m-labs/board-m1/r4/Audio.sch

## KiCad design r4/Audio.sch (2012-06-22)

Schematic: Audio.sch

Parts:
C1, C3, C13, C30, C31, C32, C254: 100n; 0402
C2, C34, C253: 10u; 0805P
C4, C5, C7, C8, C9, C10, C11, C12, C14, C18, C20, C35, C36: 1u; 0402
C6: 2u2; 0805P
C19, C21, C22, C23, C25: 10u; 0805
C28, C29: 33p; 0402
C255: 47n; 0402
J1, J2: SCJ368R1NUS0B00G; phonejack-3.5-5
J3: 68002-103HLF; HDR-3x1-100mil
J23, J26: 68002-104HLF; HDR-4x1-100mil
L2: CB100505T-601Y; 0402
MK1: MP33125; MIC-RA-DIP-9.7mmx6.7mm
R10, R11, R12, R20, R21, R23, R24: 6k8; 0402
R13: 2k2; 0402
R17, R18, R26, R27: 10k; 0402
R25, R233: 100k; 0402
R28: 1M; 0402
R230, R231: 100R; 0402
TP5, TP6, TP7, TP8: TESTPOINT; PAD_C_1mm
U1: WM9707SCFT/V; QFP48
V24, V25, V26, V27, V28, V29, V30, V32, V33: AVR-M1005C080MTACB; 0402
Y1: 24.576MHz; xtal4-6mmx3.6mm

Notes on the sheet:
V29, V30, V32, V33 -> AVR-M1005C080MTACB Vdc 5.5V, 33 pF@1 KHz
V[24:28] -> AVR-M1005C080MTACB Vdc 5.5V, 33 pF@1 KHz
Normal = Low Plug-in = High
DNP inputs DC block capacitors: C4 -> AUXL, C5 -> AUXR, C7 -> VIDEOL, C8 -> VIDEOR, C14 -> MIC2 DNP output DC block capacitor: C22 -> MONOOUT
Notes: 1. Tolerance about resistors is 1% in default.
