m-labs/board-m1/r4/DVI-ISingle.sch

## KiCad design r4/DVI-ISingle.sch (2012-06-22)

Schematic: DVI-ISingle.sch

Parts:
C135: 4n7; 1206
C179: 10u; 0805P
C180, C181, C182: 10n; 0402
C183, C184, C185, C186, C189, C190: 100n; 0402
C187: 1u; 0402
C188, C288: 10u; 0805
D5: AD1580BRTZ; SOT23
J17: 74320-1004; DVI-RECEPT-RA
L13: CB100505T-601Y; 0402
Q1, Q2, Q4: 2N7002MTF; SOT23
R141: 1k; 0402
R142: 560R; 0402
R143, R232, R235: 10k; 0402
R144, R145, R146: 75R; 0402
R147, R148, R149, R150: 4k7; 0402
R156: 1M; 1206
TP10: TESTPOINT; PAD_C_1mm
U18: ADV7125KSTZ140; QFP48
U19, U20: SN74LVC1G17DBV; SOT-235
U32: MIC2090-1YM5; SOT-235
V12, V13, V14, V15, V16, V17, V18, V19, V31: EZJ-Z0V80010; 0402

Notes on the sheet:
EZJ-Z0V80010 : Vdc 10V, 0.8 pF@1 MHz
Place those EZJ-Z0V80010 varistors V[12..19] close to J17's related pins.
Notes: 1. Tolerance about resistors is 1% in default.
