m-labs/board-m1/r4/Dram.sch

## KiCad design r4/Dram.sch (2012-06-22)

Schematic: Dram.sch

Parts:
C156: 1u; 0402
C157, C162, C167, C168, C169, C170, C242, C243, C244, C245, C250, C251, C252: 100n; 0402
C158, C159, C160, C161, C163, C164, C165, C166: 10n; 0402
C240, C248: 100u; 1210P
R71, R72, R73, R74, R75, R76, R77, R78, R79, R80, R81, R82, R83, R84, R85, R86, R87, R88, R89, R90, R93, R94, R95, R96, R97, R98, R99, R100, R101, R102, R103, R104, R105, R106, R107, R108, R109, R110, R111, R112, R114, R115, R116, R117, R118, R119, R120, R121, R122, R123, R124, R125, R126, R127, R128, R129, R130, R131, R132, R133: 33R; 0402
R91: 120R; 0402
R92, R113, R134, R135: 1k; 0402
U14, U15: MT46V32M16P; TSOP-66

Notes on the sheet:
For U15
For U14
Notes: 1. Tolerance about resistors is 1% in default.
Bypass Cap.: Pin 1 3 9 15 18 ------------------------------ U14 C162 C243 C163+C244 C164 C245 U15 C159 C251 C158+C252 C157 C156 Pin 33 55 61 ------------------------------ U14 C165+C240 C242 C166 U15 C161+C248 C250 C160
