m-labs/board-m1/r4/EXPANSION_RESET.sch

## KiCad design r4/EXPANSION_RESET.sch (2012-06-22)

Schematic: EXPANSION_RESET.sch

Parts:
C273: 4n7; 1206
J21, J22: CONN_10X2; HE-10x2-100mil
J25: CONN_2; HE-1x2-100mil
J27: MH; SPACER-3mm-7mm-9.5mm
R30, R185: 10k; 0402
R39: 330R; 0402
R234: 1M; 1206
TP35, TP36: TESTPOINT; PAD_C_1mm
U22: XC6SLX45-2FGG484C; BGA-484
U24: APX803-40SAG-7; SOT23
U25: 74AUP1G08GW,125; TSSOP5

Notes on the sheet:
J27 : Mechanical mounting hole Place J27 close to J21:19 or 20 pin.
Note: Users can build their own extension board to connect these two J21 and J22 board-to-board female headers.
Default: M1r4 ships with the jumper plug included, one contact of the the jumper be placed on J25.1
J21, 22 Harwin p/n : M20-7831046 or FCI p/n : 87606-310LF
Notes: 1. Tolerance about resistors is 1% in default.
