m-labs/board-m1/r4/Ethernet.sch

## KiCad design r4/Ethernet.sch (2012-06-22)

Schematic: Ethernet.sch

Parts:
C37, C40, C42: 1u; 0402
C38, C39, C41, C43, C44, C45, C47, C48: 100n; 0402
C46: 4n7; 1206
J4: 48025-0002; RJ45-8-LED
L4, L5, L6: CB100505T-601Y; 0402
R29: 4k7; 0402
R31: 6k65; 0402
R32, R33, R34, R35: 49R9; 0402
R36, R38: 220R; 0402
R37: 1M; 1206
R174: 1k; 0402
TP9: TESTPOINT; PAD_C_1mm
U2: KSZ8001L; QFP48

Notes on the sheet:
Notes: 1. Tolerance about resistors is 1% in default.
