m-labs/board-m1/r4/FPGA_BANK2.sch

## KiCad design r4/FPGA_BANK2.sch (2012-06-22)

Schematic: FPGA_BANK2.sch

Parts:
R157: 10k; 0402
R158, R159, R160, R161: 0R; 0402
R164, R165: 100R; 0402
U22: XC6SLX45-2FGG484C; BGA-484

Notes on the sheet:
Notes: 1. Tolerance about resistors is 1% in default.
Configuration Mode
FPGA_M[1:0]
Master Serial/SPI
Master SelectMAP/BPI
JTAG
Slave SelectMAP
Slave Serial
Go Xilinx web for more details.
