m-labs/board-m1/r4/FPGA_BANK3.sch

## KiCad design r4/FPGA_BANK3.sch (2012-06-22)

Schematic: FPGA_BANK3.sch

Parts:
C149, C233: 100n; 0402
R162, R163, R176, R177, R178: 1k; 0402
U22: XC6SLX45-2FGG484C; BGA-484

Notes on the sheet:
H/W Control: R4 Version
Board revision :
R179
removed
DNP
DNP
rc3
rc2
none
none
rc1
R178
R177
R176
Revision
Notes: 1. Tolerance about resistors is 1% in default.
