m-labs/board-m1/r4/FPGAdec.sch

## KiCad design r4/FPGAdec.sch (2012-06-19)

Schematic: FPGAdec.sch

Parts:
C49, C69, C82, C85, C98, C103: 100u; 1210P
C50: 100u; 2010P
C51, C52, C53, C54, C55, C56, C70, C71, C72, C73, C83, C84, C86, C87, C88, C99, C100, C101, C102, C104, C105, C106: 4u7; 0805P
C57, C58, C59, C60, C61, C62, C63, C64, C65, C66, C67, C68, C74, C75, C76, C77, C78, C79, C80, C81, C89, C90, C91, C92, C93, C94, C95, C96, C97, C107, C108, C109, C110, C111, C112, C113, C114, C115, C116, C117, C118, C119: 470n; 0402

Notes on the sheet:
BANK3 decoupling
BANK2 decoupling
BANK1 decoupling
BANK0 decoupling
VCCAUX decoupling
VCCINT decoupling
