m-labs/board-m1/r4/Misc.sch

## KiCad design r4/Misc.sch (2012-06-22)

Schematic: Misc.sch

Parts:
C120, C232: 100n; 0402
C121: 1u; 0402
C122: 4n7; 1206
D1, D2, D18, D19, D20, D21, D22, D23, D24, D25, D26, D27, D28, D29, D30, D31, D32, D33, D34, D35, D36, D37, D38, D39, D40, D42: LED; LEDSMD-0603R
J5: Header4; HDR-4x1-100mil
J6: 87832-1420; he-shrouded-7x2pins-2mm
J19: 500901-0801; 10-SOCKET-RA
Q3: 2N7002MTF; SOT23
R40: 47R; 0402
R41, R42: 560R; 0402
R45: 10k; 0402
R47: 1M; 1206
R200, R201, R202, R203: 270R; 0402
R229: 1M; 0402
SW2: FSMRA2JH; TACTIL-SW-SPST-RA-1.25mm-3.86mm
TP16, TP17, TP18, TP19, TP20, TP21, TP32, TP38, TP39, TP40, TP41: TESTPOINT; PAD_C_1mm
U3: SO5032-050000-O3A-BBE-QA; xtal4-5mmx3.2mm

Notes on the sheet:
About the numbering: there used to be also SW1 and SW3 (and BTN1/3), but we found that one button is all we need, and removed them.
LED_PWR: pulldown -> D1 OFF LED_PWR: PWM -> D1 Variable Luminance LED_PWR: pullup -> D1 ON
1. D[18..41] is p/n: APA1606SURCK Hyper Red color 2. Placement LEDs above on bottom side of PCB and under corresponding connector. 3. D[34..41] are placed closely board edge bottom side under between SW2 and IR
D1 and D2 are on pcb bottom side and in hyper red color of p/n: APA1606SURCK And D2 is under SW2 button and D1 is under J11 DC jack connector
DMX TX
DMX RX
MIDI TX
MIDI RX
LINE IN
LINE OUT
VIDEOIN R
VIDEOIN B
VIDEOIN G
MIC
DVI-I
USB-A
USB-B
USB-C
USB-D
Notes: 1. Tolerance about resistors is 1% in default.
