m-labs/board-m1/r4/MiscControl.sch

## KiCad design r4/MiscControl.sch (2012-06-22)

Schematic: MiscControl.sch

Parts:
C123, C124, C125: 100n; 0402
C126: 470n; 0402
D4: TS4148 RY; 0805P
D6, D7, D8, D9, D10, D11, D12, D13: BZX84-C4V3; SOT23
J7: NC3FAH1; XLR-PANEL-HORIZ/PCB-SOCKET
J8: NC3MAH; XLR-PANEL-HORIZ/PCB-PLUG
J9, J10: 671-0500; DIN-SOCKET-PCB-5-45
R48, R49, R52, R53: 10R; 0402
R50, R51, R54: 120R; 0402
R55, R56, R57: 220R; 0402
R58: 100R; 0402
TP31: TESTPOINT; PAD_C_1mm
U4, U5: SN75HVD12D; SOIC-8
U6: 6N138S; MDIP-8-355mil
U7: SN74LVC1G17DBV; SOT-235
U8: TSOP34838; TSOP348
V34: AVR-M1005C08MTACB; 0402

Notes on the sheet:
Vdc 5.5V, 33 pF @ 1 KHz
D[6..11]: P/N -> BZX84-C4V3 450 pF @ 1 MHz
DMX port A ( TX )
DMX port B ( RX )
Notes: 1. Tolerance about resistors is 1% in default.
