m-labs/board-m1/r4/NORFlash.sch

## KiCad design r4/NORFlash.sch (2012-06-27)

Schematic: NORFlash.sch

Parts:
C127: 1u; 0402
C128, C129, C130: 100n; 0402
R183, R184: 4k7; 0402
TP37: TESTPOINT; PAD_C_1mm
U9: JS28F256J3F105; TSOP-56

Notes on the sheet:
Notes: 1. Tolerance about resistors is 1% in default.
