m-labs/board-m1/r4/Power.sch

## KiCad design r4/Power.sch (2012-06-22)

Schematic: Power.sch

Parts:
C131, C132, C136, C137, C140, C141, C142, C143, C150, C151, C236, C237, C284, C285: 100n; 0402
C133, C138, C139, C148: 47u; 1210P
C134, C145: 1u; 0402
C144, C154, C234, C235: 10u; 0805P
C146, C147, C152, C155: 4n7; 1206
C153: 3n3; 0402
D14, D15, D16, D17: SMBJ5339B-TP; DO-214AA
F2, F3: MINISMDC200F-2; 1812
J11: SCD441CPS011B00G; DCJACK-14.4mmx9mm
J12, J13, J14, J15: MH; SPACER-3mm-7mm-9.5mm
L7, L8, L9, L10, L12, L20, L21: FBMJ3216HM600-T; 1206
R62: 2k32; 0603
R63: 86k6; 0402
R64, R180: 169k; 0402
R65, R66, R68, R69: 1M; 1206
R67: 1k4; 0402
R70: 1k; 0402
R181: 442k; 0402
TP1, TP2, TP3, TP4, TP26: TESTPOINT; PAD_C_1mm
TP33, TP34: TESTPOINT; PAD_C_80x80
U10: LP38690DT-3.3; TO-252
U11: PTH04000WAH; EUS
U12, U23: TPS76301; SOT-235
U13: LP38511TJ-ADJ; TO-263

Notes on the sheet:
J[12:15] are the mechanical mounting holes at each corner of PCB.
See datasheet for R62 placement in details.
D[14..17]: P/N - SMBJ5339B-TP
Notes: 1. Tolerance about resistors is 1% in default.
