m-labs/board-m1/r4/USBExtPorts1.sch

## KiCad design r4/USBExtPorts1.sch (2012-06-22)

Schematic: USBExtPorts1.sch

Parts:
C171, C172, C174, C175, C256, C257, C258: 1u; 0402
C173, C176: 470n; 0402
C177: 4n7; 1206
C178: 220u; c-smd-6.3mmx8mm
C259, C260: 150u; TC-B-3528-21-B
J16: 67298-4090; USB-A-DUAL-RECEPT-RA
R136, R137, R138, R140: 24R; 0402
R139: 1M; 1206
R166, R167, R170, R171: 15k; 0402
R168, R169, R172, R173: 1k5; 0402
R186, R187: 10k; 0402
TP22, TP23, TP24, TP25, TP27, TP28, TP29, TP30: TESTPOINT; PAD_C_1mm
U16, U17: MIC2550AYTS; TSSOP-14
U26: AP21X2A; SOIC-8
V1, V2, V3, V4: V0402MHS03; 0402

Notes on the sheet:
V[1..4]: P/N - V0402MHS03 3pF, 42Vdc
Full-speed USB Device
Notes: 1. Tolerance about resistors is 1% in default.
Pull up/down configuration
USB Host
Low-speed USB Device
R168
R169
DNP
MOUNT
USB A PORT
R166
R167
R172
R173
USB B PORT
R170
R171
