m-labs/board-m1/r4/USBExtPorts2.sch

## KiCad design r4/USBExtPorts2.sch (2012-06-22)

Schematic: USBExtPorts2.sch

Parts:
C261, C262, C265, C266, C268, C270, C271: 1u; 0402
C263, C272: 470n; 0402
C267, C269: 150u; TC-B-3528-21-B
J20: 67298-4090; USB-A-DUAL-RECEPT-RA
R188, R189, R190, R191: 24R; 0402
R194, R195, R198, R199: 15k; 0402
R196, R197: 10k; 0402
U27, U28: MIC2550AYTS; TSSOP-14
U29: AP21X2A; SOIC-8
V8, V9, V10, V11: V0402MHS03; 0402

Notes on the sheet:
V[8..11]: P/N - V0402MHS03 3pF, 42Vdc
Notes: 1. Tolerance about resistors is 1% in default.
