m-labs/board-m1/r4/USBIntPorts.sch

## KiCad design r4/USBIntPorts.sch (2012-06-22)

Schematic: USBIntPorts.sch

Parts:
C278, C279, C281, C282, C287: 1u; 0402
C280, C283: 470n; 0402
C286: 220u; c-smd-6.3mmx8mm
J24: CONN_5X2; HE-5x2-100mil
R217, R218, R223, R224: 24R; 0402
R221, R222, R227, R228: 15k; 0402
U30, U31: MIC2550AYTS; TSSOP-14
V20, V21, V22, V23: V0402MHS03; 0402

Notes on the sheet:
PIN 9 is KEY.
V[20..23]: P/N - V0402MHS03 3pF, 42Vdc
Notes: 1. Tolerance about resistors is 1% in default.
