m-labs/board-m1/r4/VideoIn.sch

## KiCad design r4/VideoIn.sch (2012-06-22)

Schematic: VideoIn.sch

Parts:
C191, C198, C212, C213, C222, C223, C230, C231: 10u; 0805P
C192, C194, C195, C196, C197, C199, C201, C208, C209, C214, C215, C216, C217, C220, C228: 100n; 0402
C193, C200: 100p; 0402
C210, C211, C218, C219, C221, C227, C229: 10n; 0402
C224: 82n; 0402
C225, C226: 33p; 0402
J18: SCP662CNS257U00G; RCA-3-RA
L17, L18: CB100505T-601Y; 0402
R151, R152, R153: 75R; 0402
R154: 1M; 0402
R155: 1k69; 0402
R175: 1k; 0402
TP12, TP13, TP14, TP15: TESTPOINT; PAD_C_1mm
U21: ADV7181C; QFP64
V5, V6, V7: V9MLA0402LNH; 0402
Y2: CRYSTAL; xtal2-11.5mmx4.83mm

Notes on the sheet:
Place this connection between two planes under U21 chip.
DVDD decoupling
DVDDIO decoupling
AVDD decoupling
PVDD decoupling
Notes: 1. Tolerance about resistors is 1% in default.
