m-labs/board-m1/(commit log)

2012-03-23 r4/: added basic m1 schematics files
    [m1.sch]
2012-04-09 create empty hierarchical sheet for functional block alike.
    [m1.sch]
2012-04-09 added all empty schematics
    [Audio.sch, DVI-ISingle.sch, Dram.sch, Ethernet.sch, FPGA.sch, FPGAdec.sch, Misc.sch, MiscControl.sch]
2012-04-11 add Milkymist components * place kicad-libs to .../board-m1/../../kicad-libs
2012-04-11 add NORFlash component
    [Audio.sch, DVI-ISingle.sch, Dram.sch, Ethernet.sch, FPGA.sch, FPGAdec.sch, Misc.sch, MiscControl.sch]
2012-04-11 NORFLAH: add FLASH bus
    [Audio.sch, DVI-ISingle.sch, Dram.sch, Ethernet.sch, FPGA.sch, FPGAdec.sch, Misc.sch, MiscControl.sch]
2012-04-11 NORFLAH: add FLASH D bus
    [Audio.sch, DVI-ISingle.sch, Dram.sch, Ethernet.sch, FPGA.sch, FPGAdec.sch, Misc.sch, MiscControl.sch]
2012-04-11 NORFLASH: fix the label name, adjust the flash bus
    [Audio.sch, DVI-ISingle.sch, Dram.sch, Ethernet.sch, FPGA.sch, FPGAdec.sch, Misc.sch, MiscControl.sch]
2012-04-11 NORFLASH: add gobal labels
    [Audio.sch, DVI-ISingle.sch, Dram.sch, Ethernet.sch, FPGA.sch, FPGAdec.sch, Misc.sch, MiscControl.sch]
2012-04-11 NORFLASH: add local labels, there is no A8 under JS28F256J3F105
    [Audio.sch, DVI-ISingle.sch, Dram.sch, Ethernet.sch, FPGA.sch, FPGAdec.sch, Misc.sch, MiscControl.sch]
2012-04-11 NORFLASH: update with correct JS28F256J3F105
    [NORFlash.sch]
2012-04-11 NORFLASH: finish FLASH_D local labels
    [Audio.sch, DVI-ISingle.sch, Dram.sch, Ethernet.sch, FPGA.sch, FPGAdec.sch, Misc.sch, MiscControl.sch]
2012-04-11 NORFLASH: more wires
    [NORFlash.sch]
2012-04-11 NORFLASH: add GND and TP
    [NORFlash.sch]
2012-04-11 NORFlash: finish NORFlash
    [NORFlash.sch]
2012-04-11 r4/m1.pro: added ../../kicad-libs/... to LibDir
    This way, things work when kicad-libs and board-m1 are at the same level
    and when board-m1 is one level below kicad-libs (i.e., parent of kicad-libs
    equals grandparent of board-m1)
2012-04-13 added Field for 'P/N' to part number and 'Smt' to record if DNP, correct connections.
    [NORFlash.sch]
2012-04-13 remove common.lib. use the KiCAD default device.lib
2012-04-13 Revert "remove common.lib. use the KiCAD default device.lib" we should make our own library of basic parts. in most cases, we can just adapt the default library. some parts need font size or line wid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
    This reverts commit 8e020ee2313bcf77a7d8df99364429a534f58282.
2012-04-13 MISC: add LED matrix
    [Misc.sch]
2012-04-13 added external USB ports A/B
    [USBExtPorts1.sch]
2012-04-13 added external USB ports C/D
    [USBExtPorts2.sch]
2012-04-13 added internal USB ports E/F
    [USBIntPorts.sch]
2012-04-16 update with kicad-libs. one lib per symbol
2012-04-16 linked to newer C_P, 3V3, 5V, USBEXT5V, TESTPOINT chip name
    [USBExtPorts1.sch, USBExtPorts2.sch, USBIntPorts.sch]
2012-04-16 linked J24 to Qi's 'con.lib'
    [USBIntPorts.sch]
2012-04-16 added decoupling cap. into VideoIn.sch
    [VideoIn.sch]
2012-04-16 MISC: finish LED matrix
    [Misc.sch]
2012-04-16 MISC: remove empty line, label don't support \n"
    [Misc.sch]
2012-04-16 add switch.lib
2012-04-16 MISC: add SW2
    [Misc.sch]
2012-04-16 use FSMRA2JH for sw2
    [Misc.sch]
2012-04-16 remove fsmra2jh, it's included by switch
2012-04-16 linked bnc.lib and all parts in VideoIn.sch
    [VideoIn.sch]
2012-04-17 linked to rca.lib
    [VideoIn.sch]
2012-04-17 Ethernet.sch done
    [Ethernet.sch]
2012-04-17 FPGAdec: add all components, haven't edit the label
    [FPGAdec.sch]
2012-04-17 chips added in
    [Power.sch]
2012-04-17 rough done on Power.sch
    [Power.sch]
2012-04-17 from +3.3V to 3V3
    [NORFlash.sch]
2012-04-17 MISC: add J5/J6/J19 and memcard connector, change the comment from local label to real comment
    [Misc.sch]
2012-04-18 rough Audio.sch done
    [Audio.sch, m1.sch]
2012-04-18 rough DVI-ISingle.sch done
    [DVI-ISingle.sch]
2012-04-18 place necessary parts in FPGA.sch
    [FPGA.sch]
2012-04-19 place necessary parts
    [MiscControl.sch]
2012-04-19 added VIDEOIN_LLC global lablel in VideoIn.sch
    [VideoIn.sch]
2012-04-19 changed global label text size
    [NORFlash.sch]
2012-04-19 rough FPGA.sch done
    [FPGA.sch]
2012-04-19 added mechanical mounting holes
    [Power.sch]
2012-04-20 rough MiscControl.sch done
    [MiscControl.sch]
2012-04-20 rough Dram.sch done
    [Dram.sch, m1.sch]
2012-04-20 FPGAdes: finish all labels
    [FPGAdec.sch]
2012-04-20 rough Misc.sch done
    [Misc.sch]
2012-04-20 FPGAdes: update datasheet and P/N
    [FPGAdec.sch]
2012-04-20 FPGAdes: add junctions, finish FPGAdes
    [FPGAdec.sch]
2012-04-20 MISC: update J6 about label
    [Misc.sch]
2012-04-20 FPGAdes: few cap. changed to C_P chip name.
    [FPGAdec.sch]
2012-04-20 MISC_CONTROL: missed J10 reference.
    [MiscControl.sch]
2012-04-20 fixed duplicate reference and added PWR_FLG from power.lib
    [Audio.sch, FPGA.sch, Power.sch, USBExtPorts1.sch]
2012-04-21 fixed: 1. unnecessary local labes 2. added PWR_FLG.
    [Audio.sch, DVI-ISingle.sch, Dram.sch, Ethernet.sch, FPGA.sch, FPGAdec.sch, Misc.sch, MiscControl.sch]
2012-04-22 fixed Uncoonected wires which caused by continuous global lable arrangement of FLASH_D[15..0].
    [FPGA.sch, NORFlash.sch]
2012-04-22 added R183 & changed FLASH_STS_N to FLASH_STS
    [NORFlash.sch]
2012-04-22 changed U18's pin16 local lable VGA_B7 to VGA_B0
    [DVI-ISingle.sch]
2012-04-23 corrected J21 pin assignments
    [FPGA.sch]
2012-04-23 added VIDEOIN_A3V3, VIDEOIN_A1V8 components to fix ErrType(3): Pin connected to some others pins but no pin to drive it. (i.e. a local lable can't drive to a type of Power input).
    [VideoIn.sch]
2012-04-23 added ETH_A3V3, ETH_A1V8, ETH_PLL1V8 components to fix ErrType(3): Pin connected to some others pins but no pin to drive it. (i.e. a local lable can't drive to a type of Power input).
    [Ethernet.sch]
2012-04-23 latest updated files
    [Audio.sch, DVI-ISingle.sch, Dram.sch, Ethernet.sch, FPGA.sch, FPGAdec.sch, Misc.sch, MiscControl.sch]
2012-04-23 r4/Power.sch: replaced PWR_FLAG with new POWERED
    [Power.sch]
2012-04-23 added bigger text within each hierarchical rectangle by functional naming.
    [m1.sch]
2012-04-23 FPGAdec.sch: remove 2 useless junctions
    [FPGAdec.sch]
2012-04-23 r4/FPGA.sch: redraw FLASH_A0 through _A4, magically removing the ERC issues
    [FPGA.sch]
2012-04-24 remove m1-cache from project libs we can do git clean -xdf before we start using kicad
    [Audio.sch, DVI-ISingle.sch, Dram.sch, Ethernet.sch, FPGA.sch, FPGAdec.sch, Misc.sch, MiscControl.sch]
2012-04-24 split FPGA.sch(A2 size) into two A3 size: FPGA_P1.sch, FPGA_P2.sch
    [FPGA.sch, FPGA_P1.sch, FPGA_P2.sch]
2012-04-24 sheet numbers were changed by split, other sheets need to be commited all.
    [Audio.sch, DVI-ISingle.sch, Dram.sch, Ethernet.sch, FPGAdec.sch, Misc.sch, MiscControl.sch, NORFlash.sch]
2012-04-24 this commit is to free warnings as: http://downloads.qi-hardware.com/people/adam/m1/tmp/kicad/20120424_3494_6-warnings.png
    reasons/steps on editing:
    Used a KiCad Version: (2012-04-08 BZR 3494)-testing Application: Eeschema
    Build: wxWidgets 2.8.10 (no debug,Unicode,compiler with C++ ABI 1002,GCC 4.4.3,wx containers,compatible with 2.6)
    Platform: Linux 2.6.32-40-generic i686, 32 bit, Little endian, wxGTK
    Options: KICAD_GOST=OFF
    USE_WX_GRAPHICS_CONTEXT=OFF
    USE_WX_OVERLAY=OFF
    USE_BOOST_POLYGON_LIBRARY
    1. Previous last history about splitted manually[scaled down] FPGA.sch(A2) into two A3 of FPGA_P1.sch, and FPGA_P2.sch;
    But there DRAM_A[12..0] bus and DRAM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
    [FPGA_P1.sch]
2012-04-25 used POWERED symbol (in powered.lib) to replace power symbols of AUDIO_AVDD, ETH_PLL1V8, ETH_A1V8, ETH_A3V3, VIDEOIN_A3V3, VIDEOIN_A1V8 and IR_PWR
    [Audio.sch, Ethernet.sch, MiscControl.sch, VideoIn.sch]
2012-04-25 DVI-ISingle.sch: used POWERED flg to drive VAA pins of U18.
    [DVI-ISingle.sch]
2012-04-25 unify value's naming rule
    [FPGAdec.sch]
2012-04-25 followed: http://en.qi-hardware.com/wiki/Rules_on_Editing_Schematics#Naming_Values_and_Units to unify value's naming rule
    [Audio.sch, DVI-ISingle.sch, Dram.sch, Ethernet.sch, FPGA_P1.sch, FPGA_P2.sch, Misc.sch, MiscControl.sch]
2012-04-27 followed http://en.qi-hardware.com/wiki/Rules_on_Editing_Schematics but not finished yet.
    [Audio.sch, DVI-ISingle.sch, Dram.sch, Ethernet.sch, FPGA_P1.sch, FPGA_P2.sch, FPGAdec.sch, Misc.sch]
2012-04-27 for better look: followed http://en.qi-hardware.com/wiki/Rules_on_Editing_Schematics
    [NORFlash.sch]
2012-05-03 1. split FPGA_P[1..2].sch into FPGA_BANK[0..3].sch and EXPANSION_RESET.sch 2. moved few applicative power symbols into local folder ../components/ 3. followed http://en.qi-hardware.com/wiki/Rules_on_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
    [Audio.sch, DVI-ISingle.sch, Dram.sch, Ethernet.sch, FPGAdec.sch, Misc.sch, MiscControl.sch, NORFlash.sch]
2012-05-03 split FPGA_P[1..2].sch into FPGA_BANK[0..3].sch and EXPANSION_RESET.sch
    [EXPANSION_RESET.sch, FPGA_BANK0.sch, FPGA_BANK1.sch, FPGA_BANK2.sch, FPGA_BANK3.sch]
2012-05-03 remove FPGA_P[1..2].sch
    [FPGA_P1.sch, FPGA_P2.sch]
2012-05-03 r4/m1.pro: keep ../../kicad-libs/components in LibDir
2012-05-04 make D+, D- lines with more clearance
    [USBExtPorts1.sch, USBExtPorts2.sch, USBIntPorts.sch]
2012-05-04 make ground symbols downward if there's more space. otherwise upward.
    [Audio.sch]
2012-05-07 fixed few items by followed: http://lists.milkymist.org/pipermail/devel-milkymist.org/2012-May/003001.html
    [Audio.sch, MiscControl.sch, USBExtPorts1.sch]
2012-05-08 added Board revision histories.
    [FPGA_BANK3.sch]
2012-05-08 Ethernet.sch: dragged nETH_RESET up and put the resistor R174 (and GND) under it.
    [Ethernet.sch]
2012-05-08 modified notes text by Werner's better suggesttions. :-)
    [EXPANSION_RESET.sch]
2012-05-08 r4/Makefile: new targets "pdf" and "view" for overview PDF of schematics
2012-05-08 followed http://lists.milkymist.org/pipermail/devel-milkymist.org/2012-May/003001.html
    [Audio.sch, DVI-ISingle.sch, MiscControl.sch, Power.sch, USBExtPorts1.sch, USBExtPorts2.sch, USBIntPorts.sch, VideoIn.sch]
2012-05-09 MiscControl.sch: make zerners vertically
    [MiscControl.sch]
2012-05-09 Audio.sch: moved texts to better places.
    [Audio.sch]
2012-05-09 MiscControl.sch: changed D[6..13] to chip name ZENER-13
    [MiscControl.sch]
2012-05-11 Misc.sch: 1. mirror few leds to not overlap '2' pin number. 2. added lables for leds
    [Misc.sch]
2012-05-11 Misc.sch: removed duplicated lable.
    [Misc.sch]
2012-05-15 Misc.sch: removed text of "Placement (TP32, TP38-TP41) at the bottom of PCB."
    [Misc.sch]
2012-05-16 board-m1/dsv/: move dsv/ over from wernermisc/m1r4/dsv/
    Also add top-level Makefile. All this still needs a bit of cleaning up.
    [milkymist_one_bom_r4.csv]
2012-05-17 followed by: http://lists.milkymist.org/pipermail/devel-milkymist.org/2012-May/003032.html
    [Audio.sch, DVI-ISingle.sch, Dram.sch, EXPANSION_RESET.sch, Ethernet.sch, FPGA_BANK0.sch, FPGA_BANK1.sch, FPGA_BANK2.sch]
2012-05-18 MK1: part number MP33125
    [milkymist_one_bom_r4.csv]
2012-05-18 followed by: http://lists.milkymist.org/pipermail/devel-milkymist.org/2012-May/003034.html
    [Audio.sch, DVI-ISingle.sch, Dram.sch, EXPANSION_RESET.sch, Ethernet.sch, FPGA_BANK2.sch, FPGA_BANK3.sch, Misc.sch]
2012-05-19 Dram.sch: indicating bypass capacitors to dram pins
    [Dram.sch]
2012-05-19 Dram.sch: moved C156 to right of C252.
    [Dram.sch]
2012-05-21 Dram.sch: fixed wrong type texts on C163+C244 instead of C162+C244
    [Dram.sch]
2012-05-21 DVI-ISingle.sch: fixed cross-style junction between R[144..146] and GND.
    [DVI-ISingle.sch]
2012-06-19 1. associated components and footprints 2. added export file(.stf) for component/footprint used by Eeschema.
    [Audio.sch, DVI-ISingle.sch, Dram.sch, EXPANSION_RESET.sch, Ethernet.sch, FPGA_BANK0.sch, FPGA_BANK1.sch, FPGA_BANK2.sch]
2012-06-20 Power_Tree.sch: added new sheet for power tree
    [Power_Tree.sch, m1.sch]
2012-06-21 updated power tree contents and added notes, not finished yet.
    [Power_Tree.sch, m1.sch]
2012-06-21 USBExtPort1.sch: added Pull up/down configuration table for Host and Full/Low-speed Device.
    [USBExtPorts1.sch]
2012-06-21 FPGA_BANK2.sch: added configuration table for FPGA_M[1:0] nets.
    [FPGA_BANK2.sch]
2012-06-22 added brand and classification name of fields and enable both for chips.
    [Audio.sch, DVI-ISingle.sch, Dram.sch, EXPANSION_RESET.sch, Ethernet.sch, FPGA_BANK0.sch, FPGA_BANK1.sch, FPGA_BANK2.sch]
2012-06-22 Power_Tree.sch: added info for FPGA block
    [Power_Tree.sch]
2012-06-25 Power_Tree.sch: added currents
    [Power_Tree.sch]
2012-06-27 added 'PowerTree' for pdf generation
2012-06-27 removed R60(DNP), R61(DNP); see reasons in details in #milkymist: http://en.qi-hardware.com/mmlogs/milkymist_2012-06-27.log.html#t01:32
    [NORFlash.sch, milkymist_one_bom_r4.csv]
